Hyllesen/CatTracker/docs/plans/remote-nodes/SESSION-2026-11-07.md

# Session notes — 7 Nov (handoff)

State at the end of the session, for whoever picks this up next. Everything below is
uncommitted (`git status` shows it), so read this before committing.

## What the boards are

Both C3 boards are on the bench, plugged into the Mac. **Nothing is in a tree right now.**

| board | MAC | port | running now |
|---|-----|---|---|
| node 1 | `80:53:e0:a0:be:30` | `/dev/cu.usbmodem211301` | `poc915` `-DROLE=2 -DNODE_ID=1` (new build, battery code in) |
| base3 | `80:53:e0:a2:f8:50` | `/dev/cu.usbmodem111301` | `gateway` with the battery + charging changes, on WiFi, publishing to MQTT |

Identify by MAC, never by the `usbmodem` suffix.

## 1. The RAK3172 was never dead — a stale binary was the whole fault

Node 1 was running `gateway/wifi_check`, which never touches UART2, so the
"24 probes over 40 s, no reply" recorded on 6 Nov was nobody probing the module. The
boot banner names the firmware: opening the port **DTR low** resets the C3 and prints
it. Reflashing `-DROLE=2 -DNODE_ID=1` → the module answered on the **first** probe,
acked every send, and its RA-02 decoded all three collars.

Acceptance against base3 (`python3 tools/poc_watch.py 120`): 15 reports, `missed 0`,
915 rssi −21..−16 dBm, all three collars at the house, base-vs-node RSSI inside ±3 dB
(mean +1.2, spread −3..+3). Node 1 is live in Home Assistant:
`sensor.cat_base_3_node_1_node_3_packets` climbs every 8 s, `in_range` is `on`.

Three observer bugs made a healthy link look dead, and all three are fixed in
`tools/poc_watch.py`: base3 prints `[RX] node …` only when verbose is on (key `v` —
the watch now sends `v`), the regex was pinned to the old `cat 2 rssi -90` wording, and
the firmware prints `cat <id> seq <collarseq> r<rssi>` with base3 omitting `dBm`/`dB`.

## 2. Battery monitoring — firmware done, hardware not

Node reports now carry a tail: `CAT1 12 c1 s163 r-55 b3325 q1` (`b` = millivolts at the
cell, `q` = TP5000 CHRG, 1 = charging). Absence is published as JSON null, so a node
with no divider fitted does not read as a flat cell. Volts, never a percentage:
LiFePO4's curve is flat.

Done and verified on the bench:

- `poc915` node role: `BAT_ADC`/`BAT_DIV`/`CHRG_PIN` build flags, `battMv()`/`chgState()`
  (under 2000 mV is read as "no cell"), key `u` prints `[batt] mV charge ADC divider`,
  the beat line carries `batt`/`chg`, tail appended to the report.
- `poc915/rak_event.h` `tailInt()` parses `b`/`q`; tests added to
  `poc915/test_rak_event.cpp` — **all pass**.
- `gateway/state_json.h` publishes `nb`/`nq` per node, discovery records for
  `base3_n<N>_battery` (unit `V`, device_class `voltage`) and `base3_n<N>_charging`.
  `gateway/test_state_json.cpp` — **all pass**.
- base3 console prints `cell <mV> chg <n>` on the `[RX]` line and in the `[v]` report.
- HA: node battery + charging entities exist for n0..n3, and node 1's two tiles were
  added to `dashboard-cats` (`python3 tools/cats_dashboard.py --base base3 --node 1 2 3
  --add-tiles --write`).
- `tools/node_check.py` (new) prints per-node `in_range / last_seen / packets / missed /
  cell V / charging`, warns below 3.10 V, exits nonzero if no node is reporting.
  `python3 tools/node_check.py`, `--watch 120`, `--nodes 1,2`. It reads entity ids out of
  the registry by unique_id and states over REST, because this install answers **no**
  state WebSocket command (`get_state`, `state/get`, `state/get_all` →
  `unknown_command`). `HA_TOKEN` in `~/.zshrc` is valid; the one in `AGENTS.md` is not.

Two silent traps found and fixed:

- `MAXREC` was 82 with the new fields, so the last two discovery records were dropped
  and the console printed "82 of 82 built". It is 90 now.
- `device_class: charging` is **not** a valid HA binary_sensor class; it must be
  `battery_charging`. The record reached the broker and the count looked complete; the
  only symptom was missing entities. The error was in HA's log:
  `echo ughugh | sudo -S docker exec homeassistant cat /config/home-assistant.log` on
  `m710q`.

## 3. Design written, not built

`docs/plans/remote-nodes/fota-and-field-check.md` — nodes out of 2.4 GHz range make BLE
the transport. Facts from the toolchain: the **default** ESP32 partition scheme already
has `app0` + `app1` (1.3 MB each), the sketch is 340 KB, and core 3.3.12 ships
`ArduinoOTA` + `tools/espota.py`. Plan: BLE service `CATNODE-<id>` with `STATUS`/
`OTA_CTRL`/`OTA_DATA`/`OTA_EVT`, `esp_ota_ops` writing the **other** slot, whole-image
CRC32 before switching boot partition, rollback marked valid only after a base ack, and
BLE opened by a magnet on the enclosure (never advertising permanently). Client is
`tools/ble_ota.py` (bleak, the pattern of `tools/ble_roster.py`) on a laptop, not the
phone app. 915 is for **config commands**, not for code (~1.2 KB/s, 10–20 min, blinds
reporting). ESPHome's OTA is WiFi-only, so it buys nothing for the deep-jungle nodes.

Throughput numbers in that file are arithmetic, not measured. Replace them.

## 4. What needs doing next

1. **Wire the battery on a node board**: divider → **GPIO3 (A3)** 100 kΩ/100 kΩ + 100 nF
   (**not** on a strap: GPIO2/8/9 are straps), TP5000 `CHRG` → a GPIO with
   `INPUT_PULLUP`. Then
   `arduino-cli compile --fqbn "esp32:esp32:esp32c3:CDCOnBoot=cdc" --build-property "compiler.cpp.extra_flags=-DROLE=2 -DNODE_ID=1 -I$PWD/homebase/esphome -DBAT_ADC=3 -DBAT_DIV=2 -DCHRG_PIN=<pin>" --output-dir /tmp/poc_node poc915`
   and upload with `--input-dir /tmp/poc_node`. Verify console `u` against a multimeter
   and watch the HA tile move when the panel is covered/uncovered.
2. **base3's own cell**: `./gateway/build.sh --flash --port=/dev/cu.usbmodem<base3> --bat=3 --chrg=<pin>`.
   **The last `./gateway/build.sh` run did not finish inside my session — re-run it and
   read the output before trusting the build.**
3. **base→node ack** (`ACK <node> <seq>` via `AT+PSEND` inside the node's 250 ms slot,
   node arms RX after its TX, stores `last_ack_age`) → then the BLE `STATUS` service →
   then `tools/ble_ota.py` + the **rollback test** (push a corrupt image, watch it roll
   back). Bench, node 1, before anything climbs a tree.
4. **Four decisions for the owner**: laptop to the tree or phone only; reed switch vs
   button vs BLE permanently on; BLE/OTA in `poc915` node role or in the production node
   firmware with the 9-byte `0xD1` codec; measured average node current with the LiFePO4
   6Ah so BLE's window is budgeted, not assumed.
5. **30-minute acceptance**: `python3 tools/poc_watch.py 1800` (120 s passed).
6. **Node 2 and 3**: no boards built, and `dashboard-cats` has **no rows for them**
   (`cats_dashboard.py` reported "no dashboard rows for node 2/3"). If they are never
   built, delete the rows and shrink `NUM_NODES` in `gateway/state_json.h`.
7. **Entity ids are cosmetically damaged** (`cat_base_3_node_1_node_1_battery`). Names
   are right, ids are not; removing the base3 *config entries* is the fix, and
   `config/device_registry/remove_config_entry` returned `unknown_error` on this install.
   A HA restart is the clean-up. Never hand-type these ids.
8. **Commit the work** — 16 modified files, 2 new, all tests passing.
