Hyllesen/CatTracker/collar/collar.ino

#include <Arduino.h>
// Required to link the USB CDC implementation behind Serial on the nRF52 core.
// Arduino.h declares Serial when USE_TINYUSB is set, but without this the
// Adafruit_TinyUSB library is never added to the build and the link fails with
// "undefined reference to Adafruit_USBD_CDC". The core's own examples do this too.
#include <Adafruit_TinyUSB.h>
#include <nrf.h>

// ---------------------------------------------------------------------------
// Build mode
// ---------------------------------------------------------------------------
// Compile with -DDEV_MODE for development (fast diagnostics, battery every 5s).
// Normal build = production (battery every 10 min).
//
//   arduino-cli compile --fqbn "adafruit:nrf52:feather52840" \
//     --build-property "compiler.cpp.extra_flags=-DDEV_MODE" \
//     collar/collar.ino
//
// Or add -DDEV_MODE to the extra-flags field in Arduino IDE preferences.
#ifndef DEV_MODE
#define DEV_MODE 0
#else
#undef DEV_MODE
#define DEV_MODE 1
#endif
// ---------------------------------------------------------------------------

// ---------------------------------------------------------------------------
// Collar identity
// ---------------------------------------------------------------------------
// Every collar needs its own id, set at flash time:
//
//   arduino-cli compile --fqbn "adafruit:nrf52:feather52840" \
//     --build-property "compiler.cpp.extra_flags=-DCOLLAR_ID=1" \
//     collar/collar.ino
//
// The id rides in byte 2 of every packet, so the handheld can tell the cats
// apart and the app can show one row per cat.
//
// The id is NOT derived from the chip's hardware id. Three collars are
// flashed and installed at different times, so any mapping from a hardware
// id onto a small slot would put two of them in the same slot - and they
// cannot negotiate their way out of it, because the link is strictly
// one-way. Flashing a collar twice with the same id is the one mistake that
// is invisible until two cats merge into one row on the phone.
//
// The chip's factory DEVICEID is printed by the 'v' command instead, so you
// can write it on the enclosure and confirm which physical collar you just
// flashed.
#ifndef COLLAR_ID
#define COLLAR_ID 0
#endif

// How many collars the handheld tracks at once. Bounded by the roster the
// handheld publishes: 2 bytes of header plus 6 bytes per collar, which has to
// fit in one BLE notification without MTU negotiation.
#ifndef MAX_COLLARS
#define MAX_COLLARS 3
#endif

#if COLLAR_ID < 0 || COLLAR_ID >= MAX_COLLARS
#error "COLLAR_ID must be between 0 and MAX_COLLARS-1"
#endif
// ---------------------------------------------------------------------------

// ---------------------------------------------------------------------------
// Cat collar transmitter - TENSTAR ROBOT nRF52840 Pro Micro + RA-02 (SX1278)
//
// Uses bit-banged SPI on the pins already wired to the RA-02. No DIO0 is
// required: transmit completion is detected by polling the IRQ flags register
// over SPI. Register values below match RadioLib's SX1278 driver exactly, so
// these air settings interoperate with the handheld's RadioLib receiver.
// ---------------------------------------------------------------------------

struct GPin { NRF_GPIO_Type* port; uint8_t n; };

// Silkscreen numbers are raw port.pin, so "011" is P0.11 - NOT P1.11. The
// three-digit form is ambiguous on its face, and guessing wrong here is silent:
// with SCK on a dead pad the radio is never clocked, every register reads 0x00,
// RegVersion never equals 0x12, and the collar looks exactly like a flat battery.
// Confirmed by brute-forcing the bus until RegVersion read 0x12 - P0.11 was the
// only SCK of 128 tried that answered.
const GPin P_SCK  = { NRF_P0, 11 };
const GPin P_MISO = { NRF_P0,  2 };
const GPin P_MOSI = { NRF_P1, 15 };
const GPin P_CS   = { NRF_P1, 13 };
const GPin P_RST  = { NRF_P0, 31 };

inline void outMode(GPin p) { p.port->DIRSET = 1UL << p.n; }
inline void inMode(GPin p)  { p.port->PIN_CNF[p.n] = 0; }  // input, buffer connected
inline void wr(GPin p, bool v) {
  if (v) p.port->OUTSET = 1UL << p.n; else p.port->OUTCLR = 1UL << p.n;
}
inline bool rd(GPin p) { return (p.port->IN >> p.n) & 1; }

uint8_t spiByte(uint8_t out) {          // SPI mode 0, MSB first
  uint8_t in = 0;
  for (int i = 7; i >= 0; i--) {
    wr(P_MOSI, out & (1 << i));
    delayMicroseconds(2);
    wr(P_SCK, 1);
    delayMicroseconds(2);
    in = (in << 1) | rd(P_MISO);
    wr(P_SCK, 0);
  }
  return in;
}

uint8_t readReg(uint8_t addr) {
  wr(P_CS, 0);
  spiByte(addr & 0x7F);                 // MSB 0 = read
  uint8_t v = spiByte(0x00);
  wr(P_CS, 1);
  return v;
}

void writeReg(uint8_t addr, uint8_t value) {
  wr(P_CS, 0);
  spiByte(addr | 0x80);                 // MSB 1 = write
  spiByte(value);
  wr(P_CS, 1);
}

// ---- SX1278 registers ----
const uint8_t REG_FIFO               = 0x00;
const uint8_t REG_OP_MODE            = 0x01;
const uint8_t REG_FRF_MSB            = 0x06;
const uint8_t REG_FRF_MID            = 0x07;
const uint8_t REG_FRF_LSB            = 0x08;
const uint8_t REG_PA_CONFIG          = 0x09;
const uint8_t REG_OCP                = 0x0B;
const uint8_t REG_LNA                = 0x0C;
const uint8_t REG_FIFO_TX_BASE_ADDR  = 0x0E;
const uint8_t REG_FIFO_TX_CURR_ADDR  = 0x0D;
const uint8_t REG_IRQ_FLAGS_MASK     = 0x11;
const uint8_t REG_IRQ_FLAGS          = 0x12;
const uint8_t REG_MODEM_CONFIG_1     = 0x1D;
const uint8_t REG_MODEM_CONFIG_2     = 0x1E;
const uint8_t REG_MODEM_CONFIG_3     = 0x26;
const uint8_t REG_PREAMBLE_MSB       = 0x20;
const uint8_t REG_PREAMBLE_LSB       = 0x21;
const uint8_t REG_PAYLOAD_LENGTH     = 0x22;
const uint8_t REG_HOP_PERIOD         = 0x24;
const uint8_t REG_DETECT_OPTIMIZE    = 0x31;
const uint8_t REG_INVERT_IQ          = 0x33;
const uint8_t REG_INVERT_IQ2         = 0x3B;
const uint8_t REG_DETECTION_THRESH   = 0x37;
const uint8_t REG_SYNC_WORD          = 0x39;
const uint8_t REG_PA_DAC             = 0x4D;  // SX1278-specific

// ---- Air settings - MUST match the handheld ----
const float   FREQ_MHZ   = 433.0;
const float   BANDWIDTH  = 125.0;
const uint8_t SPREADING  = 9;
const uint8_t CODING_R   = 7;    // 4/7
const uint8_t SYNC_WORD  = 0x12;
const int8_t  TX_POWER   = 17;   // dBm (PA_BOOST path)
const uint16_t PREAMBLE   = 8;

// Derived encodings
const uint8_t BW_125K_RAW = 0x70;  // ModemConfig1 bits 7:4
const uint8_t SF9_RAW     = 0x90;  // ModemConfig2 bits 7:4
const uint8_t CR_4_7_RAW  = 0x06;  // ModemConfig1 bits 3:1

// Collar pings this often. The handheld's receive window must cover the
// SLOWEST collar's period, not this one - see RX_TIMEOUT_MS in
// handheld_ble/handheld_ble.ino.
//
// The handheld publishes to the phone once per received packet, so this value
// also sets the gap between BLE notifications. That coupling is real but is NOT
// a link-reliability constraint: both 5s and 8s were measured delivering
// cleanly (notify_ok climbing every beacon, notify_fail frozen at the count
// reached before the phone connected). 8s is kept for the battery win.
//
// A gap in notifications of tens of seconds is NOT this constant misbehaving.
// It is the phone having dropped the BLE link - almost always because someone
// opened the handheld's serial port, which resets the ESP32 and leaves a ghost
// connection. The app then measures the sparse notifications it does receive
// and reports a wrong "next in" countdown. Hold the port open for the whole
// session when testing, as tools do.
const uint32_t PING_INTERVAL_MS = 8000;

// Each collar pings on its OWN slightly different period, offset by its id.
//
// Why not a fixed phase (all collars ping every 8 s, but collar 2 waits
// 2.7 s before its first ping)? Because a fixed phase only avoids collisions
// if every collar happens to boot at the right moment relative to the others.
// Flash and install them a day apart and the phases are whatever the
// installation order happened to produce - and if two land within one 140 ms
// airtime of each other they collide EVERY cycle, which hides two of the
// three cats completely, forever.
//
// A different period per collar cannot get stuck: the relative phase drifts by
// PING_PERIOD_STEP_MS every cycle, so any accidental alignment moves apart on
// its own. The cost is a small, constant collision probability instead of
// none - roughly 1.75% per pair per cycle, since a 140 ms packet overlaps
// another only when their start times land within 140 ms of each other - and
// a cadence that differs by at most 0.3 s between cats, which is
// imperceptible.
//
// 137 ms is deliberately not a round number and not a divisor of the
// interval: it keeps the three periods from re-aligning on a short cycle.
const uint32_t PING_PERIOD_STEP_MS = 137;
const uint32_t COLLAR_PERIOD_MS = PING_INTERVAL_MS + COLLAR_ID * PING_PERIOD_STEP_MS;

// How long loop() sleeps in one go before servicing the serial port. Long
// enough that tick suppression actually saves power, short enough that a
// 'v' typed at the bench is answered promptly.
const uint32_t IDLE_SLICE_MS = 250;

// ---------------------------------------------------------------------------
// Battery sense
// ---------------------------------------------------------------------------
// Wire the cell's POSITIVE terminal to BATT_PIN through a resistor divider.
// Two equal resistors give the 1:2 below, which keeps a 4.2V cell (3.6V ADC
// reference) comfortably inside range and costs ~20uA, against ~10mA for
// the radio. Use 100k + 100k: a 10k pair would draw 210uA and cost ~3mAh
// over a 16h run, which is real on a 150mAh cell. The 50kΩ Thevenin
// impedance keeps the SAADC's sampling cap settled within the core's
// default 3 µs acquisition time (datasheet limit 10kΩ is reached with the
// 100nF reservoir cap); 1MΩ would be 5× over and read ~7% low.
//
// BATT_PIN is an ARDUINO PIN INDEX, not the raw port number printed on the
// silkscreen. analogRead() maps the index through the core's pin table, and
// anything that does not resolve to AIN0..AIN7 falls through to `return 0` -
// a silent hardcoded zero, not a wrong reading.
//
// The pad marked "029" is P0.29, which is Arduino index 20 on this core
// (named A6 in the Adafruit variant - note the variant's A0 is P0.04, not
// P0.02, so the letter aliases are not a safe way to reason about it).
//
// Verified by the reading, not by the pin name: a healthy 4.1V cell through
// a 1:2 divider should read ~2.05V at the pin. 0V means the pin is floating
// or wrong; 3.3V means the divider is missing and the full cell is reaching
// the ADC.
const uint8_t BATT_PIN = 20;          // Arduino index for P0.29 (silkscreen "029")
const float   BATT_DIVIDER = 2.0f;    // equal high/low resistors
// The core configures the SAADC with RESP=Bypass and pre-gain 6, giving a
// full-scale of 0.6V bandgap × 6 = 3.6V. Not VDD (3.3V) — using 3300 here
// made every reading 8.3% low.
const float   VREF_MV = 3600.0f;
// The core runs the SAADC with RESP set to Bypass, so its result is NOT scaled
// to VDD the way a normal conversion is. Asking for 12-bit does not give more
// precision here - it gives a 10-bit value wearing a 12-bit label. Left at the
// core's default 10-bit, 2.03V at the pin reads 629, which matches a
// multimeter. Do not raise this without re-checking the scale.
const float   ADC_MAX = 1023.0f;     // 10-bit, core default

#if DEV_MODE
// Development: battery every 5 s so voltage changes are visible immediately.
const uint32_t BATT_SAMPLE_MS = 5000;
#else
// Production: battery every 10 min to minimise SAADC power draw.
const uint32_t BATT_SAMPLE_MS = 600000;
#endif

// Charge curve for a single-cell LiPo, open-circuit, at a light load. A cell
// sagging under load reads lower than these points, which is the safe
// direction - it warns early rather than late.
struct BattPoint { float mv; uint8_t pct; };
const BattPoint BATT_CURVE[] = {
  {4200, 100}, {4000, 85}, {3800, 55}, {3700, 25},
  {3600, 10},  {3400, 0},
};
const uint8_t BATT_CURVE_N = sizeof(BATT_CURVE) / sizeof(BATT_CURVE[0]);

uint32_t lastBattMs = 0;
uint8_t batteryPct = 0;
bool batteryValid = false;
float batteryMv = 0.0f;

uint32_t battRaw[6];

uint8_t readBatteryPercent() {
  // analogRead() enables the SAADC on every call (wiring_analog_nRF52.c:188,
  // in analogRead_internal) and never disables it again, so the peripheral is
  // left powered between reads, drawing a few hundred uA of bias current. In
  // production this function runs once every 10 minutes, which would make that
  // draw permanent. Disable it here rather than before the reads, so the
  // core's own enable stays the only thing turning it on.
  for (uint8_t i = 0; i < 6; i++) {
    battRaw[i] = analogRead(BATT_PIN);
  }
  NRF_SAADC->ENABLE = 0;
  // The first SAADC reading is unreliable — the internal reference and
  // charge pump have not settled, so it is typically low. Average all six
  // to cancel out that warm-up artefact and random noise.
  uint32_t raw = 0;
  for (uint8_t i = 0; i < 6; i++) {
    raw += battRaw[i];
  }
  raw = raw / 6;
  batteryMv = (raw * VREF_MV / ADC_MAX) * BATT_DIVIDER;

  // A pin that is not wired reads the pin's own leakage floor; treat anything
  // below a plausible cell voltage as "no reading" rather than 0%.
  if (batteryMv < 2000.0f) {
    batteryValid = false;
    return 0;
  }
  batteryValid = true;
  float mv = batteryMv;

  if (mv >= BATT_CURVE[0].mv) return BATT_CURVE[0].pct;
  for (uint8_t i = 1; i < BATT_CURVE_N; i++) {
    if (mv >= BATT_CURVE[i].mv) {
      float span = BATT_CURVE[i - 1].mv - BATT_CURVE[i].mv;
      float frac = (BATT_CURVE[i - 1].mv - mv) / span;
      float pct = BATT_CURVE[i - 1].pct + frac * (BATT_CURVE[i].pct - BATT_CURVE[i - 1].pct);
      return (uint8_t)(pct + 0.5f);
    }
  }
  return 0;
}

// ---------------------------------------------------------------------------
// Packet format - MUST match the handheld
// ---------------------------------------------------------------------------
// Six bytes, little-endian where it matters:
//
//   byte 0   0xC1        magic / protocol version
//   byte 1   seq         wrapping 0..255, increments every ping
//   byte 2   id          0..MAX_COLLARS-1
//   byte 3   battery     0..100, 0xFF = unknown (ADC pin unwired)
//   byte 4   flags       bit0 = LOW_BATT (<15%), rest reserved
//   byte 5   reserved
//
// Six bytes is not an arbitrary number. At SF9/BW125 the payload rounds up to
// whole symbols, so five bytes and six bytes cost exactly the same airtime:
// payload symbols = ceil((8*6 - 4*9 + 28 + 16) / 36) = 2, so the whole frame
// is on the air for (8 + 4.25 + 2*11) * 4.096 ms = 140 ms. The old 13-byte
// ASCII payload needed four symbols - 230 ms - so the binary frame cuts the
// transmit burst by 90 ms, which is most of what is left of the collar's
// power budget now that the fixed draws are gone.
//
// The magic byte rejects anything that is not one of ours, so a stray decoded
// frame can never turn into a phantom cat. LoRa's own payload CRC already
// covers transmission errors, so there is no CRC of our own.
const uint8_t FRAME_MAGIC = 0xC1;
const uint8_t FRAME_LEN   = 6;
const uint8_t FLAG_LOW_BATT = 0x01;

// Battery reading carried in the frame. 0xFF means "no reading", which is
// what the collar sends until the battery divider is wired to pin 029.
const uint8_t BATT_UNKNOWN = 0xFF;

uint8_t seqCounter = 0;

// Build the 6-byte frame. Built from the live battery reading rather than a
// literal so the reported figure tracks the cell.
void buildFrame(uint8_t* out) {
  out[0] = FRAME_MAGIC;
  out[1] = seqCounter++;
  out[2] = COLLAR_ID;
  out[3] = batteryValid ? batteryPct : BATT_UNKNOWN;
  out[4] = (batteryValid && batteryPct < 15) ? FLAG_LOW_BATT : 0x00;
  out[5] = 0x00;
}

// Read-modify-write of bits [startBit..endBit] in a register. RadioLib writes
// modem registers this way, which preserves the chip's power-on default bits
// (e.g. RegModemConfig2 bit2 CRC aggregation, RegInvertIQ bits 5:3, RegDetect-
// Optimize bits 7:3). Full-byte writes zero those and break interop - the
// receiver then reports RADIOLIB_ERR_LORA_HEADER_DAMAGED (-24).
void setRegBits(uint8_t reg, uint8_t value, uint8_t startBit, uint8_t endBit) {
  // Same semantics as RadioLib's Module::SPIsetRegValue: `value` is already
  // positioned at its bit offset, and bits [endBit..startBit] are replaced.
  uint8_t mask = (uint8_t)~((0xFF << (startBit + 1)) | (0xFF >> (8 - endBit)));
  uint8_t cur  = readReg(reg);
  writeReg(reg, (uint8_t)((cur & ~mask) | (value & mask)));
}

void radioInit() {
  // LoRa modem select (bit 7 = 1), then standby
  writeReg(REG_OP_MODE, 0x80 | 0x00);   // LoRa | sleep
  delay(1);
  writeReg(REG_OP_MODE, 0x80 | 0x01);   // LoRa | standby
  delay(1);

  // Frequency: FRF = (freq_hz * 2^19) / 32e6
  uint32_t frf = (uint32_t)((FREQ_MHZ * 1000000.0f * 524288.0f) / 32000000.0f);
  writeReg(REG_FRF_MSB, (frf & 0xFF0000) >> 16);
  writeReg(REG_FRF_MID, (frf & 0x00FF00) >> 8);
  writeReg(REG_FRF_LSB, frf & 0x0000FF);
  delay(1);

  // Frequency hopping off
  writeReg(REG_HOP_PERIOD, 0x00);

  // PA config: PA_BOOST, MaxPower | (power - 2), PA_DAC boost off
  writeReg(REG_PA_CONFIG, 0x80 | 0x70 | (TX_POWER - 2));
  writeReg(REG_PA_DAC, 0x04);           // default PA ramp time, boost off

  // Over-current protection on at 60 mA (raw = (60-45)/5 = 3)
  writeReg(REG_OCP, 0x20 | 3);

  // Modem config 1: bandwidth (7:4), coding rate (3:1), payload CRC on (2), explicit header (0)
  setRegBits(REG_MODEM_CONFIG_1, BW_125K_RAW, 7, 4);
  setRegBits(REG_MODEM_CONFIG_1, CR_4_7_RAW,  3, 1);
  setRegBits(REG_MODEM_CONFIG_1, 0x04,       2, 2);   // payload CRC on
  setRegBits(REG_MODEM_CONFIG_1, 0x00,       0, 0);   // explicit header

  // Modem config 2: spreading factor + single-TX mode (7:3), CRC mode (2)
  setRegBits(REG_MODEM_CONFIG_2, SF9_RAW | 0x00, 7, 3);
  setRegBits(REG_MODEM_CONFIG_2, 0x04, 2, 2);        // CRC aggregation on

  // SF7-SF12 detection optimization + threshold
  setRegBits(REG_DETECT_OPTIMIZE, 0x03, 2, 0);
  writeReg(REG_DETECTION_THRESH, 0x0A);

  // IQ inversion "off": Rx path normal (bit6=0), Tx path ON (bit0=1).
  // This is inverted-sounding but it is what RadioLib's invertIQ(false) does -
  // see RadioLib issue #778. Getting bit 0 wrong means TX "succeeds" but the
  // receiver never decodes it.
  setRegBits(REG_INVERT_IQ, 0x00, 6, 6);
  setRegBits(REG_INVERT_IQ, 0x01, 0, 0);
  writeReg(REG_INVERT_IQ2, 0x1D);

  // AGC loop enabled (gain = 0), matching RadioLib's default setGain(0)
  setRegBits(REG_MODEM_CONFIG_3, 0x04, 2, 2);   // AGC loop on

  // Preamble length
  writeReg(REG_PREAMBLE_MSB, (PREAMBLE >> 8) & 0xFF);
  writeReg(REG_PREAMBLE_LSB, PREAMBLE & 0xFF);

  // Sync word (private network)
  writeReg(REG_SYNC_WORD, SYNC_WORD);

  // FIFO base at 0, LNA boost on (bits 1:0)
  writeReg(REG_FIFO_TX_BASE_ADDR, 0x00);
  setRegBits(REG_LNA, 0x03, 1, 0);
}

// Print key registers so config problems are visible without a scope.
void printRegCheck() {
  uint32_t frf = ((uint32_t)readReg(REG_FRF_MSB) << 16) |
                 ((uint32_t)readReg(REG_FRF_MID) << 8)  |
                  (uint32_t)readReg(REG_FRF_LSB);
  float actualMHz = (float)frf * 32000000.0f / 524288.0f / 1000000.0f;

  Serial.print(F("  FRF   0x"));
  Serial.println(frf, HEX);
  Serial.print(F("  Freq  "));
  Serial.print(actualMHz, 3);
  Serial.println(F(" MHz"));
  Serial.print(F("  MC1   0x"));
  Serial.println(readReg(REG_MODEM_CONFIG_1), HEX);
  Serial.print(F("  MC2   0x"));
  Serial.println(readReg(REG_MODEM_CONFIG_2), HEX);
  Serial.print(F("  Sync  0x"));
  Serial.println(readReg(REG_SYNC_WORD), HEX);
  Serial.print(F("  InvIQ 0x"));
  Serial.println(readReg(REG_INVERT_IQ), HEX);
  Serial.print(F("  PA    0x"));
  Serial.println(readReg(REG_PA_CONFIG), HEX);
}

// Park the radio in sleep between pings. Standby with the crystal running
// costs 1.6 mA continuously (datasheet IDDST), and the collar spends ~96% of
// its life between packets, so leaving it in standby dominated the whole
// budget. Sleep is 0.2 uA (IDDSL) - three orders of magnitude cheaper.
//
// This is LoRa sleep (modem bit 7 set, mode bits 00), not FSK sleep. Waking
// is handled by radioInit(), which always rewrites the full modem register
// set rather than trusting that sleep retained it: RegFifoAddrPtr,
// RegIrqFlags and RegModemStat are among the registers that do not survive.
void radioSleep() {
  writeReg(REG_OP_MODE, 0x80 | 0x00);   // LoRa | sleep
}

// Transmit one packet; returns true if TxDone was observed before timeout.
//
// Assumes the radio is awake. loop() calls radioInit() before this.
bool sendPacket(const uint8_t* payload, uint8_t len) {
  const uint32_t timeoutMs = 3000;   // far above the 140 ms the frame needs
  writeReg(REG_OP_MODE, 0x80 | 0x01);   // LoRa | standby

  // FIFO pointer to base
  writeReg(REG_FIFO_TX_CURR_ADDR, 0x00);
  writeReg(REG_FIFO_TX_BASE_ADDR, 0x00);

  // Payload length + payload into FIFO
  writeReg(REG_PAYLOAD_LENGTH, len);
  for (uint8_t i = 0; i < len; i++) {
    writeReg(REG_FIFO, (uint8_t)payload[i]);
  }

  // Clear any stale IRQ flags
  writeReg(REG_IRQ_FLAGS, 0xFF);

  // Start TX
  writeReg(REG_OP_MODE, 0x80 | 0x03);   // LoRa | transmit

  // Poll IRQ flags register for TxDone (bit 3); no DIO0 pin needed
  uint32_t start = millis();
  while (millis() - start < timeoutMs) {
    if (readReg(REG_IRQ_FLAGS) & 0x08) {
      writeReg(REG_IRQ_FLAGS, 0xFF);    // clear flags
      writeReg(REG_OP_MODE, 0x80 | 0x01);  // back to standby
      return true;
    }
    delay(1);
  }

  // Timed out - recover to standby
  writeReg(REG_OP_MODE, 0x80 | 0x01);
  return false;
}

uint32_t lastPingMs = 0;

// Set true with 'v' on the serial port when debugging.
//
// MUST default to false. The collar runs off a LiPo with no USB attached, and
// in that state nothing drains the CDC buffer. An unguarded Serial.print
// blocks, and because it blocks inside the transmit path the collar stops
// beaconing entirely - the failure looks exactly like a dead battery. Both
// checks matter: verboseLog is what we asked for, mounted() is what is
// physically possible.
static bool verboseLog = false;

bool sx1278Present = false;
uint8_t regVersion = 0;

bool logOk() {
  return verboseLog && TinyUSBDevice.mounted();
}
uint32_t pingCount  = 0;

void setup() {
  Serial.begin(115200);
  unsigned long t0 = millis();
  while (!Serial && millis() - t0 < 2000) delay(10);

  outMode(P_SCK); outMode(P_MOSI); outMode(P_CS); outMode(P_RST);
  inMode(P_MISO);
  wr(P_SCK, 0); wr(P_CS, 1);

  // Hardware reset
  wr(P_RST, 0); delay(10);
  wr(P_RST, 1); delay(20);

  uint8_t v = readReg(0x42);
  sx1278Present = (v == 0x12);
  regVersion = v;

  // Detection stays silent. Printing happens before the radio is usable, so a
  // blocked write here would stop the collar beaconing altogether rather than
  // merely quieting it. 'v' prints the report afterwards.
  if (sx1278Present) {
    radioInit();
    // Deliberately NOT calling analogReadResolution(12) - see ADC_MAX.
  }

  // Deliberately NOT configuring Arduino pin 0 as a button input. Pin 0 is
  // P0.11 on this core, which is SCK - leaving it as INPUT_PULLUP parked the
  // clock line high and stopped the radio responding. This board has no BOOT
  // button to read anyway; see the hardware notes in collar/README.md.
}

// Full status report, emitted on demand by the 'v' serial command.
void printConfig() {
  Serial.println();
  Serial.println(F("====================================="));
  Serial.println(F(" Cat Tracker - Collar Transmitter"));
  Serial.println(F(" nRF52840 + RA-02 (SX1278 433MHz)"));
  Serial.println(F("====================================="));

  Serial.print(F("RegVersion = 0x"));
  Serial.println(regVersion, HEX);
  if (!sx1278Present) {
    Serial.println(F("SX1278 NOT detected - check wiring/power"));
    return;
  }
  Serial.println(F("SX1278 detected, wiring OK"));

  // The radio sleeps between pings, and the SX1278 cannot be read over SPI in
  // sleep mode — every register would come back 0x00 or stale. Wake it for the
  // dump and put it back to sleep afterwards. This costs ~3 ms and only ever
  // runs on an explicit 'v', which is a bench activity anyway.
  radioInit();

  Serial.println(F("Config readback:"));
  printRegCheck();

  radioSleep();

  Serial.print(F("TX ready. Freq="));
  Serial.print(FREQ_MHZ, 1);
  Serial.print(F("MHz SF"));
  Serial.print(SPREADING);
  Serial.print(F(" sync=0x"));
  Serial.print(SYNC_WORD, HEX);
  Serial.println();
  Serial.print(F("Pinging every "));
  Serial.print(COLLAR_PERIOD_MS / 1000);
  Serial.print(F("."));
  Serial.print((COLLAR_PERIOD_MS % 1000) / 100);
  Serial.print(F("s (id "));
  Serial.print(COLLAR_ID);
  Serial.print(F(" of "));
  Serial.print(MAX_COLLARS);
  Serial.println(F(")"));

  // The factory device id is printed so a physical collar can be identified
  // after flashing - "I just flashed Miso's collar, not the spare" is a
  // question this answers, and it is the only thing on the board that
  // identifies the hardware rather than the firmware.
  Serial.print(F("Device id: 0x"));
  Serial.println((uint32_t)NRF_FICR->DEVICEID[0], HEX);
  Serial.print(F("            0x"));
  Serial.println((uint32_t)NRF_FICR->DEVICEID[1], HEX);

  Serial.print(F("Battery pin: Arduino index "));
  Serial.print(BATT_PIN);
  Serial.println(F(" (P0.29, the pad marked \"029\")"));
  Serial.println(F("'v' again to silence."));
  Serial.println();
}

void loop() {
  // Serial commands are read even with logging off, so a host can turn
  // diagnostics on over the very cable that is supplying power.
  while (Serial.available()) {
    char c = (char)Serial.read();
    if ((c == 'v' || c == 'V') && TinyUSBDevice.mounted()) {
      verboseLog = !verboseLog;
      if (verboseLog) {
        printConfig();
      }
    }
  }

  // (no manual-ping button: the board has none, and pin 0 is SCK)

  if (millis() - lastPingMs >= COLLAR_PERIOD_MS) {
    pingCount++;

    // Sample the cell on its own much slower schedule than the pings. The
    // SAADC is enabled only for the duration of the read, and the cell cannot
    // change meaningfully in the few seconds between pings.
    if (millis() - lastBattMs >= BATT_SAMPLE_MS) {
      lastBattMs = millis();
      batteryPct = readBatteryPercent();
      if (logOk()) {
        Serial.print(F("[BATT] "));
        Serial.print(batteryPct);
        Serial.print(F("%  "));
        Serial.print(batteryMv, 0);
        Serial.print(F("mV"));
        if (!batteryValid) {
          Serial.print(F("  (no reading - check pin/wiring)"));
        }
        Serial.println();
        Serial.print(F("[RAW] "));
        for (uint8_t i = 0; i < 6; i++) {
          Serial.print(battRaw[i]);
          Serial.print(' ');
        }
        Serial.println();
      }
    }

    // Wake the radio from sleep. radioInit() rather than a bare standby
    // write, because sleep does not retain the FIFO pointers or the modem
    // registers and a partial re-init would transmit on last ping's config.
    radioInit();

    uint8_t frame[FRAME_LEN];
    buildFrame(frame);
    bool ok = sendPacket(frame, FRAME_LEN);
    radioSleep();
    if (logOk()) {
      Serial.print(F("[TX] ping #"));
      Serial.print(pingCount);
      Serial.print(F(" sent (id "));
      Serial.print(COLLAR_ID);
      Serial.print(F(", seq "));
      Serial.print(seqCounter - 1);
      Serial.println(ok ? F(")") : F(" TIMEOUT)"));
    }
    lastPingMs = millis();
  }

  // Sleep until the next ping is due.
  //
  // Without this the loop spins on millis() for the whole interval, the
  // FreeRTOS idle task never gets to run, and the core stays in System ON
  // *running* at 64 MHz - roughly 3.5 mA, a third of the entire budget.
  //
  // delay() is vTaskDelay() (delay.c:48), so yielding here lets the idle task
  // suppress ticks under configUSE_TICKLESS_IDLE (FreeRTOSConfig.h:52) and
  // WFE the core into System ON idle. millis() is tick2ms(xTaskGetTickCount())
  // (delay.c:30), so it keeps counting correctly across suppressed ticks and
  // the schedule below needs no separate RTC timebase.
  //
  // Sleeping in slices rather than one long delay keeps serial responsive:
  // a 'v' arriving mid-interval is picked up within IDLE_SLICE_MS.
  if (!sx1278Present) {
    delay(COLLAR_PERIOD_MS);
    return;
  }
  while (millis() - lastPingMs < COLLAR_PERIOD_MS) {
    uint32_t remaining = COLLAR_PERIOD_MS - (millis() - lastPingMs);
    delay(remaining < IDLE_SLICE_MS ? remaining : IDLE_SLICE_MS);
    while (Serial.available()) {
      char c = (char)Serial.read();
      if ((c == 'v' || c == 'V') && TinyUSBDevice.mounted()) {
        verboseLog = !verboseLog;
        if (verboseLog) {
          printConfig();
        }
      }
    }
  }
}
