Hyllesen/CatTracker/(commit log)

2026-10-11 Added missing rn app
    [handheld_ble.ino]
2026-10-11 Track the React Native app and stop committing build output
    CatTrackApp had been recorded as a gitlink (mode 160000) in the first
    commit, because it still had its own .git at the time. Git never descends
    into a gitlink, so every file in the app was invisible to this repository
    and the "Added missing rn app" commit contained only a firmware edit.
    Removing the gitlink from the index and re-adding the path tracks the
    67 source files for real. Verified beforehand that node_modules/, build/,
    .gradle, local.properties, keystore.properties and the release keystore
    all stay excluded by the app's own .gitignore.
    Also stop tracking the 53 MB release APK and .DS_Store. The APK is
    regenerated by tools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
2026-10-11 Fix release script installing to an emulator
    The install step took whichever device adb happened to list first, so
    with both a phone and the emulator attached it installed to the emulator
    and reported Success. The emulator's Bluetooth radio is virtual and
    cannot see the handheld, so the app there looks broken for reasons that
    have nothing to do with the build.
    Emulators are now skipped, an ambiguous or absent device is an error
    rather than a guess, and an explicit serial can be passed as
    --install <serial>.
    Also avoids mapfile: the shebang resolves to macOS /bin/bash 3.2, which
    does not have it, so that would have failed on the first run.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
2026-10-11 Add dBm logger for antenna testing
    Live terminal readout plus a CSV, so swapping an antenna does not mean
    looking away at a phone screen. Port is found by probing for the handheld
    banner rather than by filename, since the usbmodem suffixes get shuffled
    between reboots.
    Writes the column layout analyze_walk.py already reads. Unlike the
    phone-side recorder, this reads the handheld's unsmoothed RSSI off the
    serial line, so that script's noise figure is a real measurement of the
    RF floor rather than a restatement of the firmware averaging window.
    Opens the receive port only, so there is nothing to transmit into a
    missing antenna.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
    [log_dbm.py]
2026-10-11 Fix crash when marking before the first packet arrives
    Pressing m immediately after the script starts is the natural thing to
    do - the key hints print as soon as the port opens, and nothing has been
    received yet. stats() returns None there, and 's_now and s_now[avg]'
    short-circuits to None, which then fails on the format spec with a
    TypeError and takes the whole run down.
    The previous test piped /dev/null so no keys were ever sent and this
    path never executed.
    Also ignore the CSV files the logger writes, so test runs do not
    accumulate as untracked files.
    [log_dbm.py]
2026-10-11 Simplify dBm logger to just print values
    Stripped the CSV recorder, markers, raw-mode key handling and argument
    parsing. The terminal readout is the whole feature; the file output was
    added without being asked for.
    Also fixes port detection, which matched on the handheld's boot banner.
    DTR is deasserted so opening the port does not reset the board, meaning a
    running handheld never prints its banner - detection only worked after a
    reset. Now it keeps whichever port actually yields a packet line, which
    does not depend on board state.
    [log_dbm.py]
2026-10-11 Show running spread in the dBm readout
    The live line only showed the average, which hides how much the reading
    is actually moving. A run drifted 6.9 dB over ~2.5 minutes while the
    average slid smoothly enough to look like a real trend - the spread has
    to be visible to tell an antenna change apart from the room moving.
    [log_dbm.py]
2026-10-12 Tag dBm runs with a config name
    The antenna comparison is five separate runs, and without a label the
    terminal scrollback is the only record of which number belonged to which
    configuration. The optional argument is printed at startup and in the
    closing summary.
    Also print spread in the summary, not just min and max, so the closing
    line can be compared directly between runs.
2026-10-12 Add collar wiring documentation
    No wiring reference existed for the collar - only handheld/README.md.
    Written while debugging a collar that had stopped transmitting after a
    counterpoise was added, so it leads with the wiring table, the silkscreen
    label gotcha (011 means P1.11, not pin 11), and a bridge table mapping an
    accidental contact to the symptom it causes.
    Antenna section records the measured counterpoise result (-1.9 dB parallel,
    +8.1 dB at 90 degrees) and the 10 dB orientation swing, so the gain is not
    assumed to be repeatable.
    Also documents the power-bank auto-off behaviour, which costs time every
    time it is rediscovered.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
2026-10-12 Correct collar wiring table: DIO0-DIO3 are unconnected
    The first version of this doc listed DIO0->015, DIO1->002, DIO2->011 and
    DIO3->013. That mapping was invented. The firmware drives exactly five
    pins - SCK, MISO, MOSI, CS and RST - and polls the SX1278 IRQ flags for
    TxDone precisely so no DIO pin is needed:
    // Poll IRQ flags register for TxDone (bit 3); no DIO0 pin needed
    The DIO rows have been replaced with an explicit 'not connected' entry,
    and the bridge table no longer lists DIO0 as a fault - it carries no
    wire, so bridging it cannot be the cause. The bridge table now lists only
    pads that actually have wires on them.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
2026-10-12 Set collar ping interval to 5s for battery life
    At the 1s bench-test interval the collar transmits ~21% of the time and
    draws ~29 mA, which flattens a 150 mAh pack in about 5 hours. At 5s it
    averages ~9.5 mA, roughly 16 hours - enough to cover a night of roaming.
    The change is coupled: the handheld derives its receive window from the
    collar interval, so COLLAR_PING_MS moved 1000 -> 5000 to match.
    RX_TIMEOUT_MS follows it to 5200 ms.
    STALE_MS rose 8000 -> 15000 so one or two missed packets do not trip
    'signal lost' on a 5 s beacon cadence.
    Verified after flashing: 7 packets in 40 s (5.7 s average, the excess
    being per-cycle receive latency), RSSI spread 0.6 dB with no drops.
    Co-Authored-B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
    [collar.ino, handheld_ble.ino]
2026-10-12 Make tones louder and slightly longer
    Logcat showed the tones were playing correctly all along - 3969 frames
    delivered per blip, at full device volume, every 5.2 s - so this was an
    audibility problem rather than a playback bug. A 0.18 s blip peaking at
    0.35 (-9 dBFS) does not reliably reach the ear on a phone speaker,
    especially outdoors.
    Peak 0.35 -> 0.8 (+7.2 dB, 2 dB of headroom so repeats cannot clip) and
    duration 0.18 s -> 0.22 s. Verified zero clipped samples.
    [make_tones.py]
2026-10-12 Add beacon countdown and pulse indicator to the app
    The tone alone cannot distinguish 'I did not hear it' from 'there was
    nothing to hear'. That ambiguity is exactly why a too-quiet tone looked
    like a broken link for an hour: the screen showed a static 100% and
    nothing indicated a beacon was even due.
    Now shows, once connected:
    - seconds since the last beacon, ticking at 5 Hz
    - seconds remaining until the next one is expected
    - a dot that pulses green for 500 ms on each beacon
    - a draining bar, turning red and reading 'no beacon' after two missed
    The expected interval is the median of the last 7 observed intervals
    rather than a hardcoded constant, so it tracks the collar's ping rat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
2026-10-12 Stop serial output from silently killing both boards
    The tracker worked on the bench for hours and then went quiet minutes
    after setup, which looked like a dying battery or the cat walking out of
    range. The handheld was in fact stalling its main loop for 52 seconds
    while packets kept arriving unheard.
    Cause: Serial is native USB CDC. Power the board from a power bank or
    wall charger and nothing ever drains that port, so the CDC buffer fills
    and Serial.print() blocks. On the collar the block lands inside the
    transmit path, so it stops beaconing entirely - indistinguishable from a
    flat cell.
    Fix: logging defaults off on both boards and is enabled by sending 'v' over
    serial. The handheld gate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
    [collar.ino, handheld_ble.ino]
2026-10-12 Report the collar cell voltage all the way to the app
    The payload has always carried bat=100 - a literal. Anyone watching the
    tracker would have been told the battery was full indefinitely, which is
    the one reading you least want to be confidently wrong about.
    Collar now samples its cell through a 1:2 divider on P0.29 and maps it
    through a real LiPo charge curve, sampled once a minute rather than every
    ping to keep the SAADC idle between reads. An unwired pin reads below the
    2000mV floor and reports '--' instead of 0%, because a false low-battery
    warning on a cat tracker is worse than no warning at all.
    Handheld parses bat= from the ASCII payload and forwards it as byte 7;
    the app renders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
    [collar.ino, handheld_ble.ino]
2026-10-12 Document the LiPo connection and battery sense in the collar README
    The wiring guide had no battery section at all, which is the one part of
    this build you cannot improvise with a breadboard in front of you.
    Records what the board photos actually show: B+/B- pads flanking the USB
    connector, separate RAW and VCC pads, and pins silkscreened with raw port
    numbers - which means the pad you solder to and the BATT_PIN constant are
    the same number, no translation between them. Battery sense goes on the
    free 029 pad.
    Also carries forward the three checks worth doing with a multimeter before
    the first permanent solder, each with a pass condition: does it charge, is
    the rail safe with USB and cell b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
2026-10-12 Redraw the battery-sense divider with a netlist fallback
    The horizontal ASCII art was hard to follow and the ambiguity it created
    is not a harmless one: reading it as a series chain puts the full cell
    voltage on an ADC pin rated to 3.0V.
    Vertical layout with the junction labelled as net B, plus a three-row
    netlist table that is unambiguous on its own without the picture.
2026-10-12 Fix netlist wording that implied soldering B- to GND
    Listing B-, the R2 leg and a GND pad on a single 'net' row reads as
    'internally common, wire them together', which is backwards - they are
    already the same node inside the board and adding a wire does nothing.
    Replaced with the four joints you actually make, and states plainly that
    B- and GND need no connection. The thing worth protecting is the one that
    does need three: 029, plus both resistor legs.
2026-10-12 Record the TENSTAR manual as the hardware source of truth
    Adds AGENTS.md so future sessions consult the board manual instead of
    inferring specs from product photos. The page itself 403s scripted
    fetches, so the summary table lives in the repo alongside the link.
    Settles three things we had been guessing at:
    - Charge rate is 100mA, not the 1A TP4056 default I had warned about.
    Retracts a warning that would have sent them looking for a resistor
    to change that does not need changing.
    - Bootloader entry is a double-short of RST to GND within 0.5s, not a
    BOOT button. Those two pads sit adjacent on the right edge.
    - In bootloader the LED fades; the application blinks. Which is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
2026-10-12 Fix battery sense reading a hardcoded zero
    analogRead() takes an ARDUINO PIN INDEX, not the raw port number printed
    on the silkscreen. Passing 29 - the number on the '029' pad - resolved to
    P0.09, fell through the core's switch to 'default: return 0', and the ADC
    reported a perfect, entirely fictional zero.
    P0.29 is Arduino index 20 on this core. That distinction is nasty because
    the variant's letter aliases do not rescue you: its A0 is P0.04, not
    P0.02, and A6 is the one that lands on P0.29.
    Reported 885mV after the fix, where the true divider output is ~2.03V
    (confirmed by multimeter). The remainder is source impedance: a 1M/1M
    divider presents 500k to a SAADC sampling with a 3us acquisi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
    [collar.ino]
2026-10-12 Fix a 4x scale error in battery measurement
    Second bug in the same feature, and a nastier one because it looked
    plausible. The Adafruit nRF52 core configures the SAADC with RESP set to
    Bypass, so the result is not scaled to VDD the way a normal conversion
    is. Calling analogReadResolution(12) does not buy precision - it returns a
    10-bit magnitude under a 12-bit label, and a correct 2519-count reading
    came back as 605.
    The tell was that six consecutive reads were identical. A settling or
    impedance problem produces drift; an exactly repeatable wrong number is a
    scale error. At the core's default 10-bit, 605 counts is 1.95V at the pin,
    which is what the multimeter said.
    Also corrects the earli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
    [collar.ino]
2026-10-14 Fix the collar radio pin and add a handheld build script
    The collar was not beaconing, and every symptom pointed somewhere else.
    It reported "SX1278 NOT detected", every transmit timed out, and the
    handheld heard nothing - which is exactly what a flat battery looks
    like, so the real cause stayed hidden.
    SCK was driven on P1.11. The silkscreen "011" is P0.11, and P1.11 is a
    pad on this board with nothing soldered to it. With no clock reaching
    the SX1278, every register read back 0x00, RegVersion never equalled
    0x12, and radioInit() was skipped - so the radio was never initialised
    and never transmitted.
    Worse, setup() also called pinMode(0, INPUT_PULLUP). Arduino pin 0 is
    P0.11 on this core,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
    [collar.ino]
2026-10-14 Add antenna trim tool and board photos; make the tool read the BLE handheld
    tune_antenna.py trims the collar radiator by sweeping its length against
    the handheld's live RSSI. Added as-is, but it did not work against the
    firmware currently on the board, so the parser is fixed here.
    It was written against handheld/handheld.ino and could not read
    handheld_ble/handheld_ble.ino at all. The two disagree on every field
    that matters:
    handheld.ino RSSI raw -41.0 dBm | SNR 10.0 dB | smoothed ...
    handheld_ble.ino RSSI -44.0 dBm smoothed -43.7 dBm snr 11.0 dB
    The word "raw" is absent, "snr" is lowercased, and the whole line is
    unwrapped. Checked against live output rather than by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
    [tune_antenna.py]
2026-10-14 Fix the antenna tool collecting nothing, and show readings as a row
    Reported as "stuck at one reading, but the numbers update". Two separate
    faults, and the second was hiding the first.
    The warmup test was inverted against itself:
    if len(self.cur.rssi) >= self.warmup:
    self.cur.rssi.append(...)
    run.rssi only grows once that test passes, so with the default warmup of
    3 the condition is 0 >= 3 forever and no sample is ever stored. Confirmed
    by replaying both conditions over 12 synthetic packets: the old one kept
    0/12 at warmup=3, the new one keeps them all. A run could never complete
    at any antenna length - the tool was collecting nothing at any setting
    other than --warmup 0, whi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
    [tune_antenna.py]
2026-10-14 Correct the battery-sense divider and sample cadence
    The 1M+1M divider left the SAADC source impedance 50x above the
    datasheet's 10k limit, so the sampling cap never settled inside the
    core's 3 us acquisition window and every reading ran ~7% low.
    - Divider is now 100k+100k, with a 100 nF reservoir cap on the "029"
    pad as a local charge source for the ADC's internal cap.
    - VREF_MV 3300 -> 3600. The core runs SAADC with RESP=Bypass and
    pre-gain 6, so full scale is 0.6V bandgap x 6, not VDD. Using 3300
    made every reading a further 8.3% low.
    - Average all six samples; the first is low because the internal
    reference and charge pump have not settled.
    - Add -DDEV_MODE for 5s battery sampli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
    [collar.ino]
2026-10-14 Add battery-life plans
    Two independent reviews of the collar power budget, kept side by side
    because they disagree on the load-bearing numbers:
    - space-bunny-battlife-plan.md is the reconciled plan. Its Step 0
    (status LED) is resolved: no LED in field operation, USB-connected
    only, so there is no LED load in the budget.
    - qwen27b-batt-life-plan.md is kept unedited for comparison.
    The disagreement worth carrying forward: SX1278 standby is 1.6 mA
    (IDDST, crystal enabled), not the 1.5 uA of the Idle row. That is 1000x
    and it is what makes the radio-sleep step worth anything.
2026-10-14 Sleep the radio and the core between pings; 5s -> 8s interval
    Three always-on loads dominated the budget, and none of them are the
    radio's airtime. Together they take the collar from ~9.4 mA / ~16 h to
    ~2.9 mA / ~39 h on the same 150 mAh cell. No RF parameter changes: same
    17 dBm, same SF9/BW125, same 15-byte packet, so range is untouched.
    1. Radio sleeps between pings (-1.6 mA)
    sendPacket() left the SX1278 in standby on both exit paths, and it
    sat there for ~96% of its life. Standby with the crystal running is
    1.6 mA (datasheet IDDST); sleep is 0.2 uA (IDDSL). That 1000x gap is
    the whole saving.
    Note the three easily-confused datasheet rows - sleep 0.2 uA
    (IDDSL), idle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
2026-10-14 Track the collar's new 8s interval
    The collar now pings every 8 s instead of 5 s, and the two handhelds
    encode that number in different ways. Only one of them would have
    broken silently.
    handheld_ble/ (the build the CatTrackApp talks to):
    COLLAR_PING_MS 5000 -> 8000. This is the load-bearing change.
    RX_TIMEOUT_MS is derived as COLLAR_PING_MS + 200, and receive()
    blocks for that long, so leaving it at 5200 ms would put the
    receiver to sleep for 3.2 s of every 8 s cycle and drop roughly half
    of all pings. Not a degraded-signal problem - a broken link.
    SMOOTH_N 12 -> 4. The old value was tuned against 5 s pings, where 12
    packets was ~60 s of history. At 8 s it spans 96 s and th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
    [handheld_ble.ino]
2026-10-14 Match the app's beacon countdown to the 8s interval
    DEFAULT_BEEP_MS 5000 -> 8000. This is only the fallback used before any
    beacons have been observed; once two land, the app derives the cadence
    from the measured interval, so it self-corrects shortly after connect.
    Left at 5000 the countdown bar would run ahead of the real schedule
    until the first two beacons arrive.
    Also corrects the wire-format comment in signal.ts, which claimed the
    stale flag meant ">8s since last" while the firmware sets it at 15000.
2026-10-14 Document the power budget and correct the LED tell
    The "Power" section claimed ~9 mA; it is now ~2.9 mA, and the number
    was what made a power bank look viable. Adds a budget table recording
    what each fix removed, because the standby/sleep distinction is the
    easy part to get wrong: the SX1278 datasheet lists sleep at 0.2 uA,
    idle at 1.5 uA and standby at 1.6 mA, and only standby applies to a
    radio waiting to transmit.
    Also records that PING_INTERVAL_MS and the handheld's COLLAR_PING_MS
    must change together, with what happens if they don't.
    LED tell: the docs claimed the application blinks, which sent the
    troubleshooting flow looking for a "steadily blinking blue LED" that
    never appears in f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
2026-10-14 Record that 8s is fine, and that the real cause was serial-port resets
    Chased a "beacon stops after 2 packets" symptom for most of a session and
    got the cause wrong twice. Recording the actual finding so it is not
    re-derived:
    The beacon interval was never the problem. Measured clean at both 5s and
    8s, with the handheld's serial port held open for the whole session:
    8s: notify_ok climbing +2 per beacon, notify_fail frozen at 4 - and all
    4 of those happened before the phone connected. Packet spacing
    8.20/8.21/8.20s. Zero failures after subscribe.
    5s: identical shape, 5.20/5.21s spacing.
    Every failure I saw followed immediately after opening or closing the
    handheld's serial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
    [collar.ino, handheld_ble.ino]
2026-10-21 Add the Report stream and the laptop monitor
    The handheld emits one machine-readable RPT line per snapshot of the collar
    state over its existing USB CDC port, gated on Serial.isPlugged() (the USB SOF
    watchdog, not DTR) so a board on a charger prints nothing and cannot wedge.
    tools/monitor.py renders it as a live dashboard, --csv/--json for piping, and
    analyze_walk.py learns the new layout.
    The cable and the phone are independent: the USB CDC peripheral and the
    Bluetooth controller are separate hardware, so plugging in does not take the
    phone offline.
    No WiFi/MQTT in the handheld: adding it took the build to 99% of the app
    partition. The house-facing half is a separate device, the homebase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
2026-10-21 Add the homebase: a base station on ESP8266 + RA-02
    A base station is a fixed, powered LoRa receiver that reports to the house over
    WiFi. It has no BLE, so the phone app does not talk to it - the phone talks to
    the handheld. Its value is placement: it sits near where the cats go.
    Separate sketch, separate board, for two measured reasons. Adding WiFi + MQTT to
    handheld_ble took the ESP32-C3 build to 99% of the app partition; a base station
    has no BLE, so this one is 26% of flash. And the walk device and the base station
    are never in the same place at the same hour.
    Publishes the same snapshot the roster and the Report are built from, as retained
    MQTT JSON, with Home Assistant discovery per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
    [homebase.ino]
2026-10-21 Fix the homebase: setServer, discovery uids, JSON truncation, pin labels
    Three bugs meant the base station published nothing, and each was silent on
    the device - no error, no output, just a board that looked alive.
    - mqtt.setServer() was never called. MQTT_BROKER and MQTT_PORT were declared
    and unused, so PubSubClient's server stayed at its default 0.0.0.0:1883 and
    connect() failed forever.
    - Discovery uids were passed to publishSensorConfig as raw format strings, so
    the topics carried a literal %u. Home Assistant rejected them as illegal
    discovery topics, and because discovery is retained all three cats collapsed
    onto one record - only Chacha survived.
    - char json[340] truncated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
    [homebase.ino]
2026-10-21 Drop the last-heard sensor, and unclamp the age
    Last heard and last seen are the same fact in two forms, and Home Assistant can
    derive the duration from the timestamp with as_timestamp(now) - as_timestamp(state),
    so the seconds sensor is redundant. It is gone; the state JSON still carries age,
    because that is the raw fact and a template can use it directly.
    The age clamp was the real problem. ageS was clamped to 255 s, and last was
    computed from the clamped value, so a collar missing for 20 minutes reported
    last = now - 255: Home Assistant showed it as heard four minutes ago, and that
    value moved forward with the clock for as long as it stayed missing. Past 255 s
    both sensors made a missing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
    [homebase.ino]
2026-10-26 Tidy the workspace: plans under docs/plans, drop the placeholder test and unused dep
    The two root battery-life plans move into docs/plans/: the space-bunny one
    keeps its reasoning and gains a note that handheld/ no longer exists, and the
    qwen one is replaced by final-battery-curve-plan.md plus the measured level
    data. tools/ble_watch.py goes with them - the laptop watch is tools/monitor.py.
    Also drops @react-native/new-app-screen (nothing imports it) and the
    placeholder App.test.tsx, which only rendered the screen; app_roster.test.tsx
    drives the real path with roster bytes now.
    collar/README.md gains the board photos, build_handheld.sh stops offering to
    build a second sketch that no longer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
    [chichi-battery-level-data.csv]
2026-10-26 Publish the latest packet's RSSI, and show dBm and SNR per cat
    The handheld averaged RSSI over 12 packets - ~96 s of history at an 8 s ping -
    so the number lagged the cat: walk past a collar and nothing on the screen
    moved for a minute and a half. It now publishes the reading for the packet
    that just arrived, which is the same packet snrLast already described, so the
    two numbers on the phone finally describe one measurement. Measured noise is
    ~0.7 dB and the tone moves in 13.5 dB steps (the 135 dB range over 10 steps),
    so a single packet's jitter never reaches the audio; pushRssi() and the
    history buffer are gone with it.
    The app drops the signal bar and its percentage. Every row shows dBm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
    [analyze_walk.py, handheld_ble.ino, log_dbm.py, monitor.py, test_monitor.py, tune_antenna.py]
2026-11-02 Plan the solar remote nodes, and fix the RX window for the ATtiny collar
    Remote nodes: ESP32-C3 + RA-02 (433 RX) + RAK3172 (915 TX) receivers in the
    trees, reporting per-ping RSSI/SNR to a new gateway `base3`. Three documents
    under docs/plans/remote-nodes/ plus a root TODO.md execution list:
    - final-remote-plan.md, the consolidated plan: band split, pin maps, power
    budget, 9-byte node frame, RAK3172 AT traps, failure modes, sources.
    - remote-node-wiring.md, the bench guide: parts, wiring, build steps A-E.
    - remote-node-wiring-corrections.md, the review that shaped them, kept as a
    record of what changed.
    Two numbers in the earlier drafts were wrong and are now fixed everywhere:
    - The 9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
    [at-tiny85-collar.ino, handheld_ble.ino, homebase.ino]
2026-11-03 Prove the 433 half: add a NODE role that hears collars and reports over 915
    Three firmware bugs made the RA-02 receive look dead, all in my code, all silent:
    RegOpMode 0x83 is TX and 0x85 is RX continuous (the radio sat in transmit, so every
    detection was its own TxDone); RegIrqFlags RxDone is 0x40 not 0x08 and ValidHeader is
    0x10, so real packets were aborted mid-reception; packet RSSI is -164 + signed(0x1A)
    for 433, not -156, and the FIFO pointer must be seeded from RegFifoRxCurrentAddr.
    Register 0x12 is RegVersion, not RegIrqFlags.
    Measured: three collars, RSSI -85..-111 dBm, misaligned=0, crc_err=0, [TX] done ok=6.
    Two guards added because the log was lying: every packet was reported tw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
    [at_probe.ino, poc915.ino, rak_event.h, test_rak_event.cpp]
2026-11-03 Watch both POC boards at once, and log the walk on battery
    Opening the port resets the C3, so DTR is set before open(), not after: setting it
    after restarts the board and the walk log was lost. Ports are chosen by USB vendor id
    0x303a, the suffix is shuffled between reboots. Role is classified by behaviour (a
    p readback answering P2P_RX_ON is the listener), not by the port name.
    [poc_watch.py]
2026-11-03 Record what the bench proved, and the two rules that cost a session
    The RAK3172 on the node board was never dead: the RA-02 was initialised before the
    RAK finished booting and the shared 3V3 dipped mid-boot, leaving the module mute.
    Reordered bring-up fixes it and self-reports. Also recorded: an unpowered SX1278 runs
    phantom-powered through its ESD diodes, so a register read is not proof of power; and
    the usbmodem suffix identifies nothing — both boards have been 111301.
    POC status, payload format, board MACs, build commands, and the cleanup items
    (.gitignore for arduino-cli build trees) go in FINDINGS.md and poc915/README.md.
    TODO task 4 is done on the bench; the end-to-end node-to-house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
2026-11-03 Prove the node-to-house hop end-to-end: 37 frames, 0 missed, payload identical
    Board 1 as node 1 (RA-02 + RAK), board 2 as the listener, 5 minutes:
    frames 37 seq 0..36 missed 0, all three collars reported at the house, and the
    node's echoed payload matched the house's decoded line byte for byte on every seq.
    tools/poc_watch.py had two reporting bugs this run exposed: the 'no collar' line
    crashed the parser, and missed was max(seq)+1 - count, which counted frames sent
    before the listener was armed as losses. It now counts gaps inside the range.
    The +/-3 dB criterion in TODO task 6 is not met by this test: the node sends the RSSI
    it measured, so the house receives the same integer by constru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
    [poc_watch.py]
2026-11-03 Board 2 is node 2: three collars, RAK answering on the first probe
    Same ROLE=2 build with -DNODE_ID=2. RA-02 reads ver 12 / FRF 6C4000 / MC1 76 / MC2 94
    / sync 12 / PA FF, decodes three collars with misaligned=0, and the RAK answered on the
    first probe with the reordered bring-up. The freshness guard works as designed: the
    first report before any collar was heard says c-1 r0, not a stale number.
    Recorded in FINDINGS.md: the board table now lists node ids, and two nodes with nobody
    listening is the state where a silent failure is invisible — keep a -DROLE=0 listener
    until a third board is available.
2026-11-03 Two nodes hear the same collars, and the cross-node RSSI is per collar, not per node
    Read both node consoles at once for 100 s: 29 (collar, seq) pairs heard by both, seqs
    identical, so the collar ids in the house are unique.
    Cross-node RSSI: cat 0 -0.2 dB, cat 1 +0.8 dB, cat 2 +4.0 dB, overall spread -2..+5.
    The boards are side by side, so this is collar position and body absorption, not node
    placement. It breaks the +/-3 dB band in TODO task 6 and means a single per-node
    rssi_offset_db cannot absorb it. TODO task 10 now asks for a per-collar term.
    Board 2 flashed as node 2. No listener is attached in that state, so the node-2 uplink
    has not been received by anything - a third board as -DR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
2026-11-03 Add a BASE role that hears collars and the node reports, and measure them packet for packet
    ROLE=3 runs the RA-02 and the RAK as RX together. The node report now carries the
    collar's own seq, so the base matches its RSSI to the node's on the same packet, not on
    a time window: matched 13, unmatched 0.
    The offsets are per collar and the sign flips: cat 0 +5 dB, cat 1 +4..+6, cat 2
    -12..-13. A board calibration bias would move every collar the same way, so this is
    geometry - which collar is nearer to which board. TODO task 6's +/-3 dB band is measured
    and not met, and a single per-node rssi_offset_db cannot absorb a per-collar term. The
    locator has to compare a node's RSSI for a cat against th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
    [poc915.ino, rak_event.h, test_rak_event.cpp]
2026-11-06 Base 3 is on the dashboard: the gateway firmware, and the two bugs that cost a session
    gateway/ builds base3 (RAK3172 on 915 + own RA-02 on 433, HA discovery, TP5000
    battery), with state_json.h host-tested before every build. The board flashes,
    associates, publishes 82 discovery records and hears all three collars:
    sensor.cat_base_3_node_3_signal reads -122 dBm for Chichi.
    Two failures found by reading the console rather than guessing:
    - The C3 scans fine and never associates. WiFi.setTxPower(8.5 dBm) after
    WiFi.begin() connects in one second; at the default the station sits at
    WL_DISCONNECTED. Built in as -DTX_POWER, printed on the w line.
    - nameAt() returns a static buffer, so keepin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
    [partitions.csv]
